urbanpixellab/CarrouselOscStepper/osc-with-python/README.md

# OSC with Python

## Installation

    sudo apt-get install python3-wheel
    sudo pip3 install python-osc

## Running

    ./server.py &
    ./client.py
    fg
