urbanpixellab/CarrouselOscStepper/osc-with-python/state-diagram.png

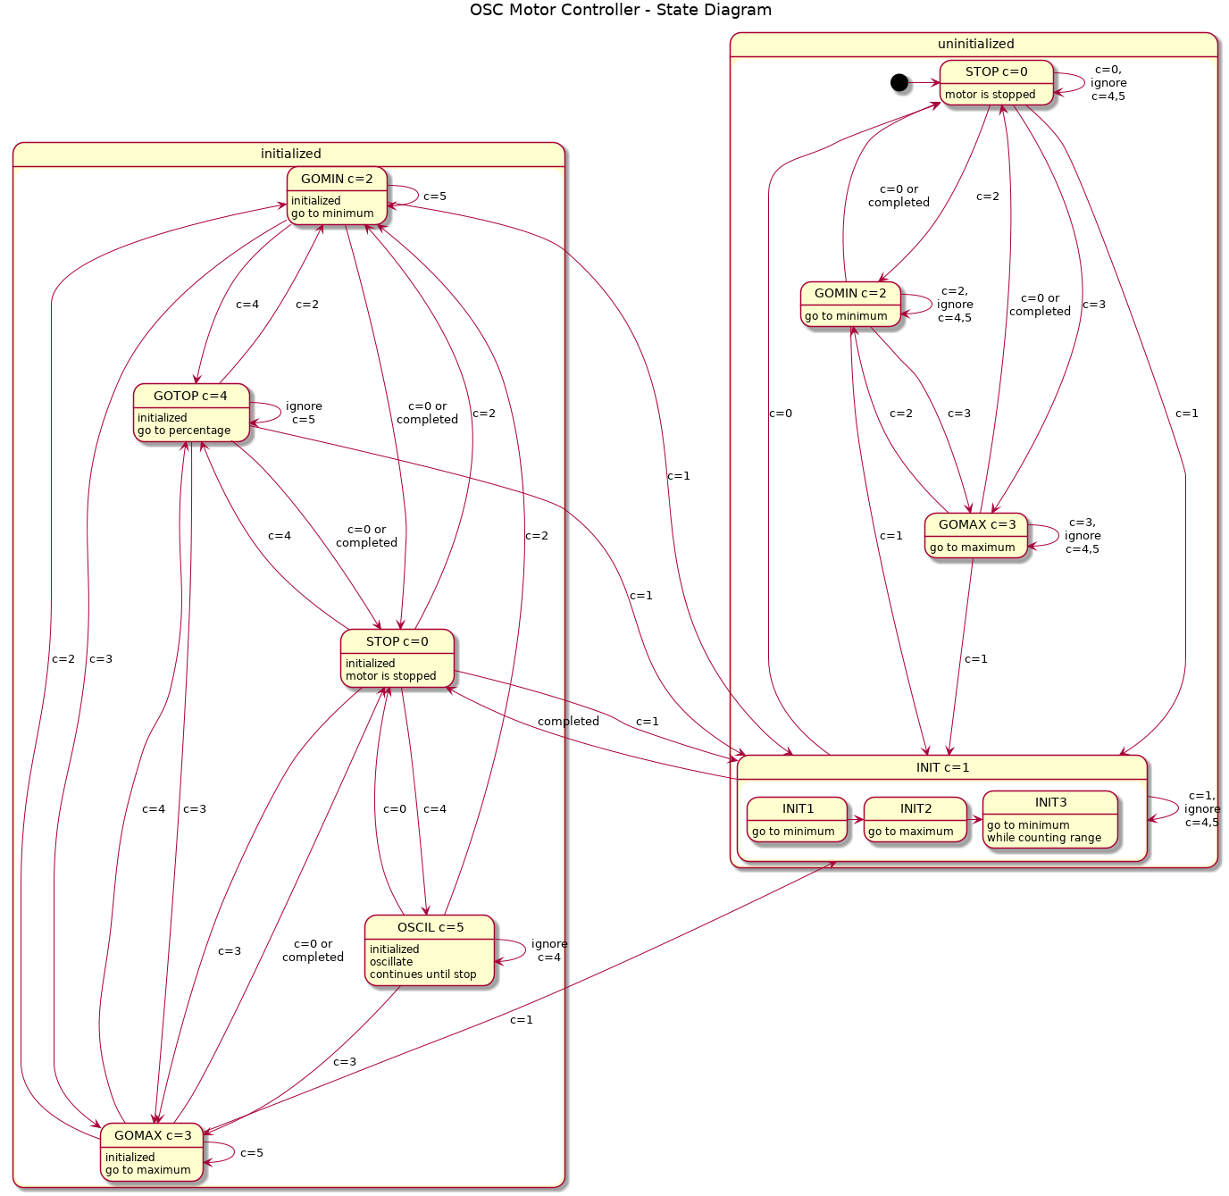
osc-with-python/state-diagram.png
