urbanpixellab/CarrouselOscStepper/PCB/Teensy_Quad_driver/SchematicStepperV3.brd

## EAGLE design PCB/Teensy_Quad_driver/SchematicStepperV3.brd (2019-08-19)

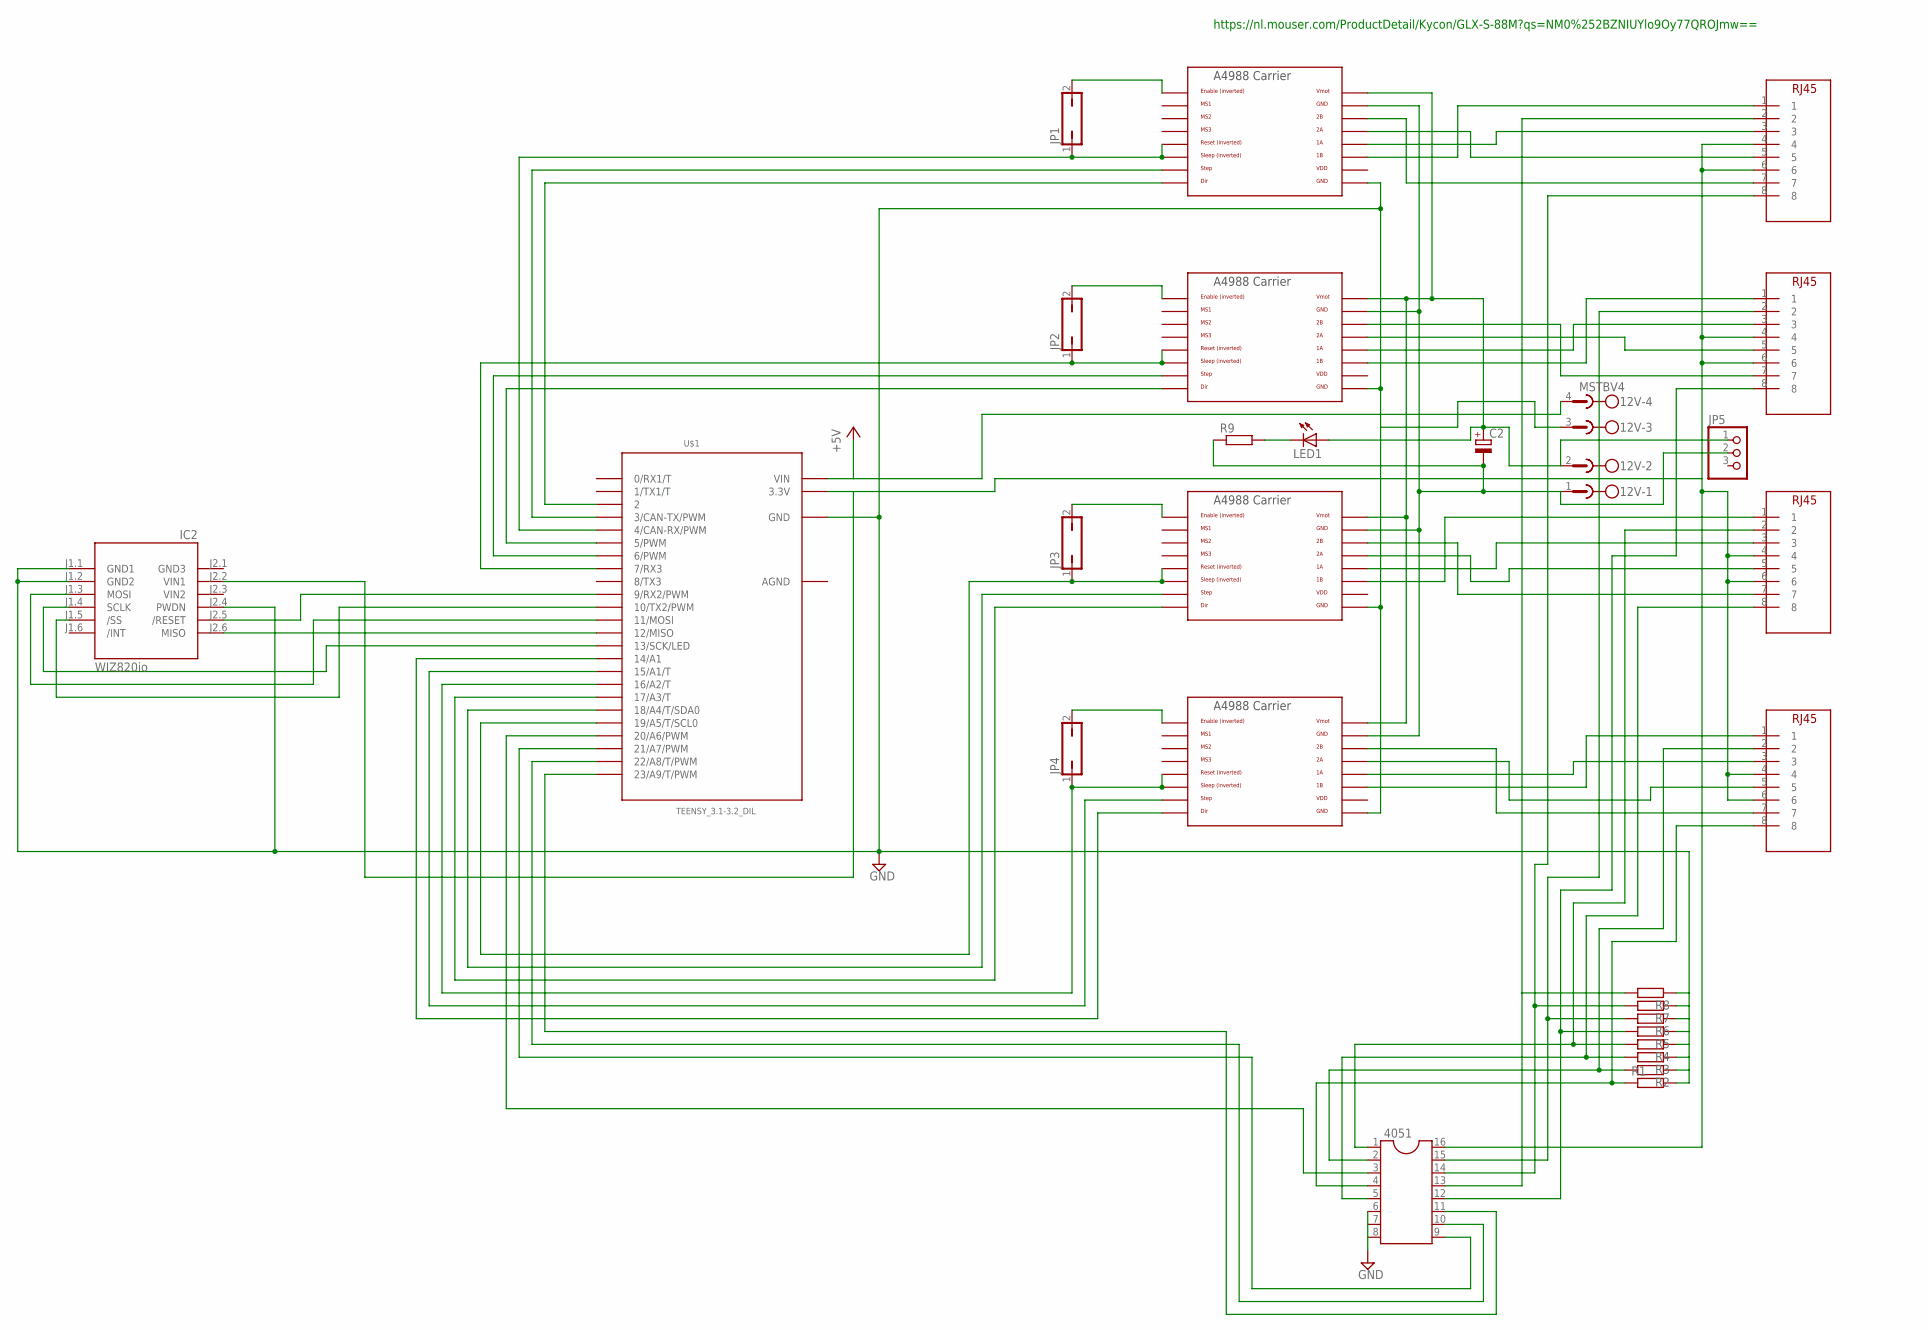
[picture p2: schematic SchematicStepperV3.sch]

Parts:
12V: MSTBV4
4051: DIL16
C2: CPOL-EUB45181B; B45181B
IC2: WIZ820io; WIZ820IO
JP1, JP2, JP3, JP4: JP1Q; JP1
JP5: PINHD-1X3; 1X03
LED1: LED_ELD260; LED_LD260
R1, R2, R3, R4, R5, R6, R7, R8, R9: R-EU_0309/10; 0309/10
U$1: TEENSY_3.1-3.2_DIL; TEENSY_3.0-3.2&LC_DIL
U$2, U$3, U$4, U$5: A4988BREAKOUT
WEIDMUELLER_RJ1, WEIDMUELLER_RJ2, WEIDMUELLER_RJ3, WEIDMUELLER_RJ4: WEIDMUELLER_RJ45

Connections:
4051: 4051.3, U$1.20/A6 (20/A6/PWM)
+5V: 12V.4, U$1.VIN
AGND: U$1.AGND
GND: 12V.3, 4051.6, 4051.7, 4051.8, IC2.J1.1 (GND1), IC2.J1.2 (GND2), IC2.J2.4 (PWDN), R1.2, R2.1, R3.1, R4.1, R5.1, R6.1, R7.1, R8.1, U$1.GND, U$2.GND, U$3.GND, U$4.GND, U$5.GND
GND3: IC2.J2.1 (GND3)
unnamed: JP2.1, U$1.7 (7/RX3), U$3.RST, U$3.SLP (SLEEP)
unnamed: 12V.1, C2.-, JP5.2, R9.1, U$2.GND_MOT, U$3.GND_MOT, U$4.GND_MOT, U$5.GND_MOT
unnamed: JP3.1, U$1.19/A5 (19/A5/T/SCL0), U$4.RST, U$4.SLP (SLEEP)
unnamed: JP1.1, U$1.4 (4/CAN-RX/PWM), U$2.RST, U$2.SLP (SLEEP)
unnamed: U$1.2, U$2.DIR
unnamed: U$1.3 (3/CAN-TX/PWM), U$2.STEP
unnamed: U$1.5 (5/PWM), U$3.DIR
unnamed: U$1.6 (6/PWM), U$3.STEP
unnamed: U$1.17/A3 (17/A3/T), U$4.DIR
unnamed: U$1.18/A4 (18/A4/T/SDA0), U$4.STEP
unnamed: 12V.2, C2.+, JP5.1, LED1.A, U$2.VMOT, U$3.VMOT, U$4.VMOT, U$5.VMOT
unnamed: JP4.1, U$1.16/A2 (16/A2/T), U$5.RST, U$5.SLP (SLEEP)
unnamed: U$3.1A, WEIDMUELLER_RJ2.3
unnamed: U$2.2B, WEIDMUELLER_RJ1.7
unnamed: U$2.1A, WEIDMUELLER_RJ1.3
unnamed: 4051.16, IC2.J2.2 (VIN1), U$1.3.3V, WEIDMUELLER_RJ1.4, WEIDMUELLER_RJ1.6, WEIDMUELLER_RJ2.4, WEIDMUELLER_RJ2.6, WEIDMUELLER_RJ3.4, WEIDMUELLER_RJ3.6, WEIDMUELLER_RJ4.4, WEIDMUELLER_RJ4.6
unnamed: IC2.J2.5 (/RESET), U$1.9 (9/RX2/PWM)
unnamed: IC2.J2.6 (MISO), U$1.12 (12/MISO)
unnamed: IC2.J1.3 (MOSI), U$1.11 (11/MOSI)
unnamed: IC2.J1.4 (SCLK), U$1.13 (13/SCK/LED)
unnamed: IC2.J1.5 (/SS), U$1.10 (10/TX2/PWM)
unnamed: U$2.2A, WEIDMUELLER_RJ1.5
unnamed: U$3.2A, WEIDMUELLER_RJ2.5
unnamed: U$3.2B, WEIDMUELLER_RJ2.7
unnamed: U$4.2A, WEIDMUELLER_RJ3.5
unnamed: U$3.1B, WEIDMUELLER_RJ2.1
unnamed: U$4.1A, WEIDMUELLER_RJ3.3
unnamed: U$4.2B, WEIDMUELLER_RJ3.7
unnamed: U$5.1A, WEIDMUELLER_RJ4.3
unnamed: U$4.1B, WEIDMUELLER_RJ3.1
unnamed: U$5.2B, WEIDMUELLER_RJ4.7
unnamed: U$5.2A, WEIDMUELLER_RJ4.5
unnamed: U$5.1B, WEIDMUELLER_RJ4.1
unnamed: LED1.K (C), R9.2
unnamed: JP1.2, U$2.EN
unnamed: JP2.2, U$3.EN
unnamed: JP3.2, U$4.EN
unnamed: JP4.2, U$5.EN
unnamed: 4051.9, U$1.21/A7 (21/A7/PWM)
unnamed: 4051.13, R8.2, WEIDMUELLER_RJ1.2
unnamed: 4051.10, U$1.22/A8 (22/A8/T/PWM)
unnamed: 4051.11, U$1.23/A9 (23/A9/T/PWM)
unnamed: 4051.14, R7.2, WEIDMUELLER_RJ1.8
unnamed: 4051.15, R6.2, WEIDMUELLER_RJ2.2
unnamed: 4051.12, R5.2, WEIDMUELLER_RJ2.8
unnamed: 4051.1, R4.2, WEIDMUELLER_RJ3.2
unnamed: 4051.5, R3.2, WEIDMUELLER_RJ3.8
unnamed: 4051.2, R2.2, WEIDMUELLER_RJ4.2
unnamed: 4051.4, R1.1, WEIDMUELLER_RJ4.8
unnamed: U$2.1B, WEIDMUELLER_RJ1.1
unnamed: U$1.15/A1 (15/A1/T), U$5.STEP
unnamed: U$1.14/A0 (14/A1), U$5.DIR
VDD: U$2.VDD, U$3.VDD, U$4.VDD, U$5.VDD
VIN2: IC2.J2.3 (VIN2)

Notes on the sheet:
https://nl.mouser.com/ProductDetail/Kycon/GLX-S-88M?qs=NM0%252BZNIUYlo9Oy77QROJmw==

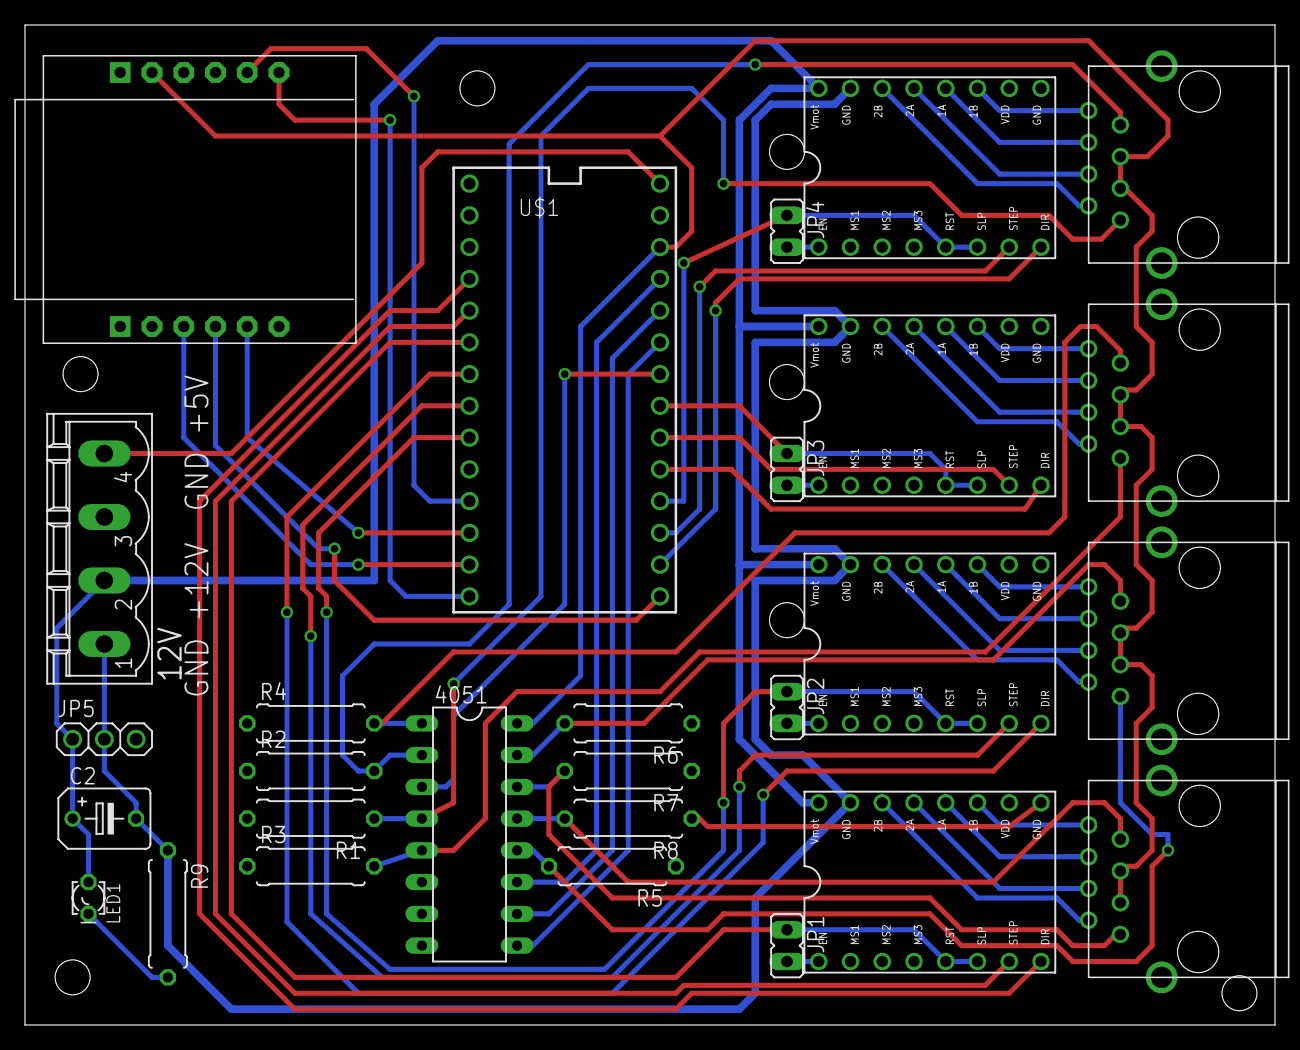
[picture p3: board SchematicStepperV3.brd from above]

Board: 2 copper layers, 100.0 x 80.0 mm, 28 parts (0 on the bottom side), 56 nets.
