urbanpixellab/CarrouselOscStepper/PCB/MotorReceive+Gerber/MotorConnection.brd

## EAGLE design PCB/MotorReceive+Gerber/MotorConnection.brd (2019-08-19)

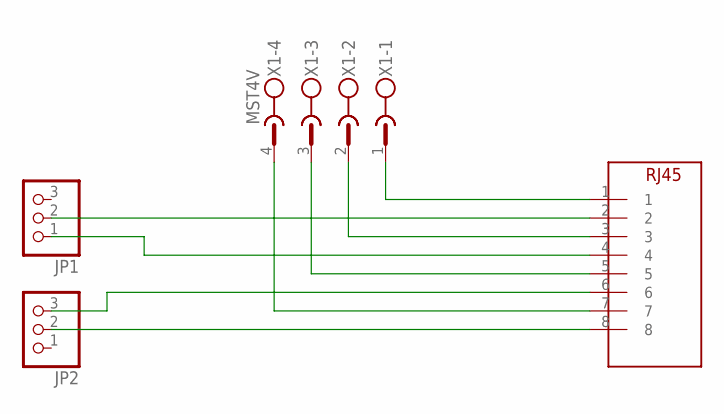
[picture p4: schematic MotorConnection.sch]

Parts:
JP1, JP2: PINHD-1X3; 1X03
WEIDMUELLER_RJ1: WEIDMUELLER_RJ45
X1: MST4V; MSTBV4

Connections:
unnamed: JP1.2, WEIDMUELLER_RJ1.2
unnamed: JP1.1, WEIDMUELLER_RJ1.4
unnamed: JP2.2, WEIDMUELLER_RJ1.8
unnamed: JP2.3, WEIDMUELLER_RJ1.6
unnamed: WEIDMUELLER_RJ1.1, X1.1
unnamed: WEIDMUELLER_RJ1.3, X1.2
unnamed: WEIDMUELLER_RJ1.5, X1.3
unnamed: WEIDMUELLER_RJ1.7, X1.4

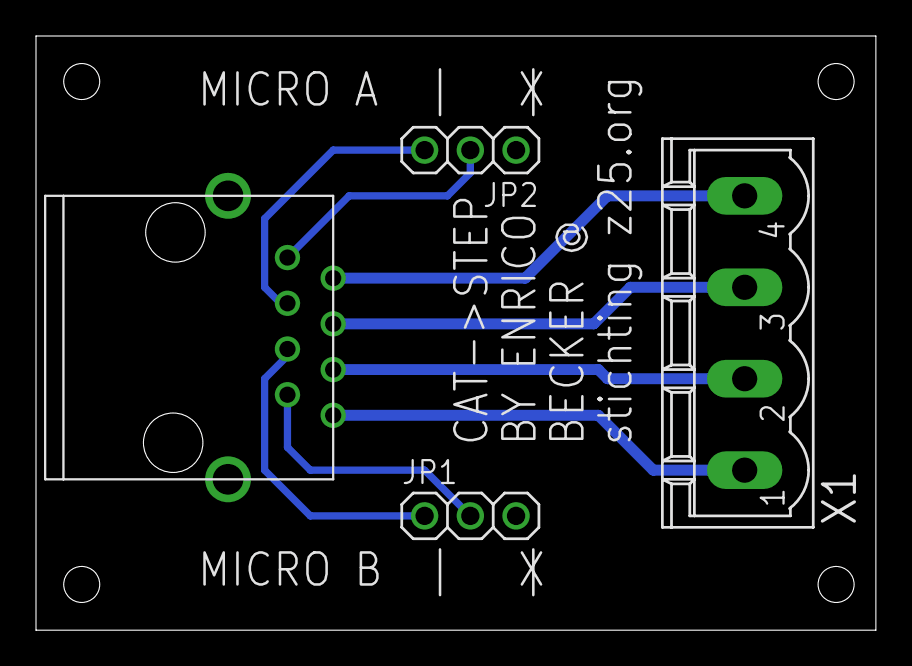
[picture p5: board MotorConnection.brd from above]

Board: 2 copper layers, 46.7 x 33.0 mm, 4 parts (0 on the bottom side), 8 nets.
