urbanpixellab/CarrouselOscStepper/(commit log)

2019-07-16 added testfiles from latest drv8825 board and updated readme
2019-07-21 implemented simple stepper function, TODO must been inserted in the main loop see coments
2019-07-21 implementedosc message onposition, must di this only once
2019-08-02 added osc feedback for microswitch and stepper on target
2019-08-16 added two buttons on 6 and 7 for on location test and removed network
2019-08-16 serial print microswitch id
2019-08-19 added pcb eagle files
    [MotorConnection.brd, MotorConnection.sch, SchematicStepperV3.brd, SchematicStepperV3.sch]
2019-08-19 added link for pcb in the netherlands to readme
2019-09-09 first version with fixed gomax
    [CarouselOscStepper.ino, client.py, server.py]
